OlivierJoris/Shop-customer-counter/README.md

# Shop customer counter
Shop customer counter made using a PIC microcontroller in Assembly. This project has been realized as part of the *Embedded systems project* course given by Bernard Boigelot at the University of Liège during the 2020-2021 academic year.
