OlivierJoris/Shop-customer-counter/0_project_idea/comments.pdf

❖ Sauvegarde de données sur la carte SD pas nécessaire
❖ Laser pas la meilleure solution
- Un laser tout seul n’est pas suffisant. Il faut un module avec un laser mais c’est peut-être trop cher pour le cours
- On peut utiliser une LED avec un “lens”
❖ Remplacer la photo-résistance par un photo-transistor
❖ On peut utiliser un seul système de détection au lieu de 2
- Un seul système de détection avec 2 “détecteurs” (pas de communication bluetooth)
■ En fonction de l’ordre dans lequel les détecteurs sont activés, on peut en déduire si la personne rentre ou sort du magasin
- On peut aussi garder notre système avec les 2 systèmes de détection
