OlivierJoris/Shop-customer-counter/3_modules_interaction/report.pdf

## INFO-2055: Embedded systems project Customer Counter - System modules interaction

Crucifix Arnaud - 170962
Goffart Maxime - 180521
Joris Olivier - 182113

## 1 Modules interaction

We build both types (emitter and receiver) circuits using breadboards.

The issues we have are the following:

1. Phototransistors and IR emitters have a range which is too short.
2. If we are not almost in the dark, the phototransistor does not allow to detect the waves from the IR emitter.

For both issues, we think that it comes from hardware choices. Maybe we do not have the ideal components for what we want to achieve. At the moment, we are using Vishay TSHF5410 (https://be.farnell.com/vishay/tshf5410/emetteur-infrarouge-890nm-t-1/dp/1652534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) as IR emitters and OP598A (https://be.farnell.com/tt-electronics-optek-technology/op598a/phototransistor-plastic-to-18/dp/1497887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) as phototransistors.

1
