OlivierJoris/Shop-customer-counter/4_final_report/diagram.png

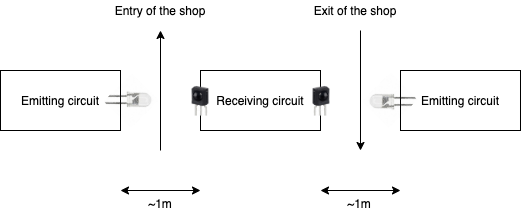
4_final_report/diagram.png
