OlivierJoris/Shop-customer-counter/4_final_report/emitter.png

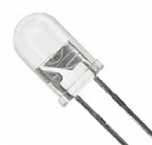
4_final_report/emitter.png
