OlivierJoris/Shop-customer-counter/4_final_report/receiver.png

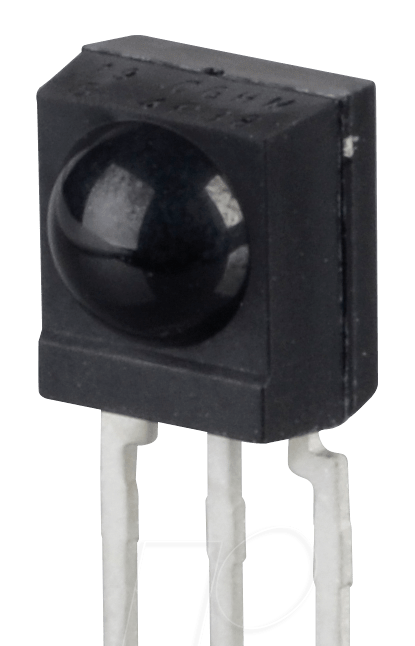
4_final_report/receiver.png
