OlivierJoris/Shop-customer-counter/1_hardware_software/schematic.pdf

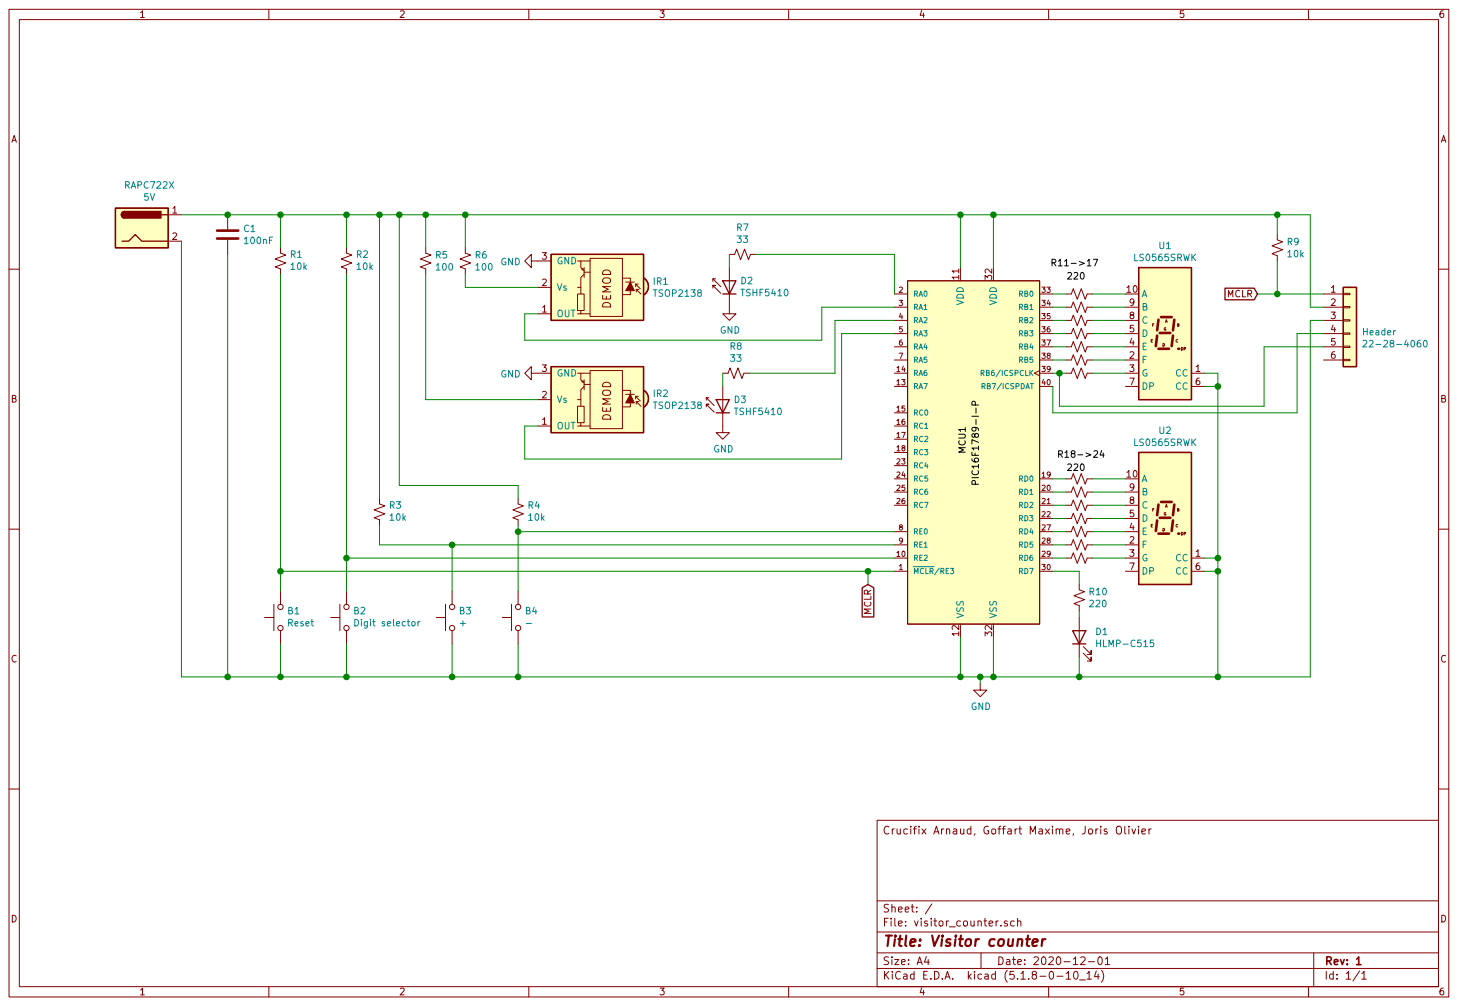
[picture p12: page 1]

File: visitor_counter.sch Sheet: / Crucifix Arnaud, Goffart Maxime, Joris Olivier

Id: 1/1 Title: Visitor counter
