OlivierJoris/Shop-customer-counter/schematics/emitter_circuit/visitor_counter_emitter.pdf

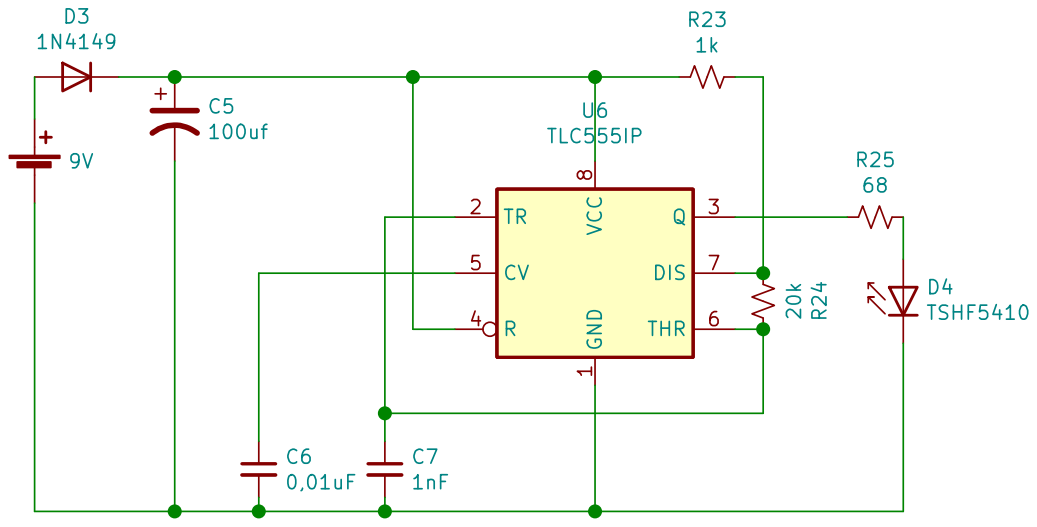
[picture p13: page 1]

INFO-2055: Embedded Systems Project Academic Year: 2020-2021

File: visitor_counter_emitter.sch Sheet: /
Id: 1/1 Title: Visitor Counter Emitter
