OlivierJoris/Shop-customer-counter/schematics/receiver_circuit/visitor_counter_receiver.pdf

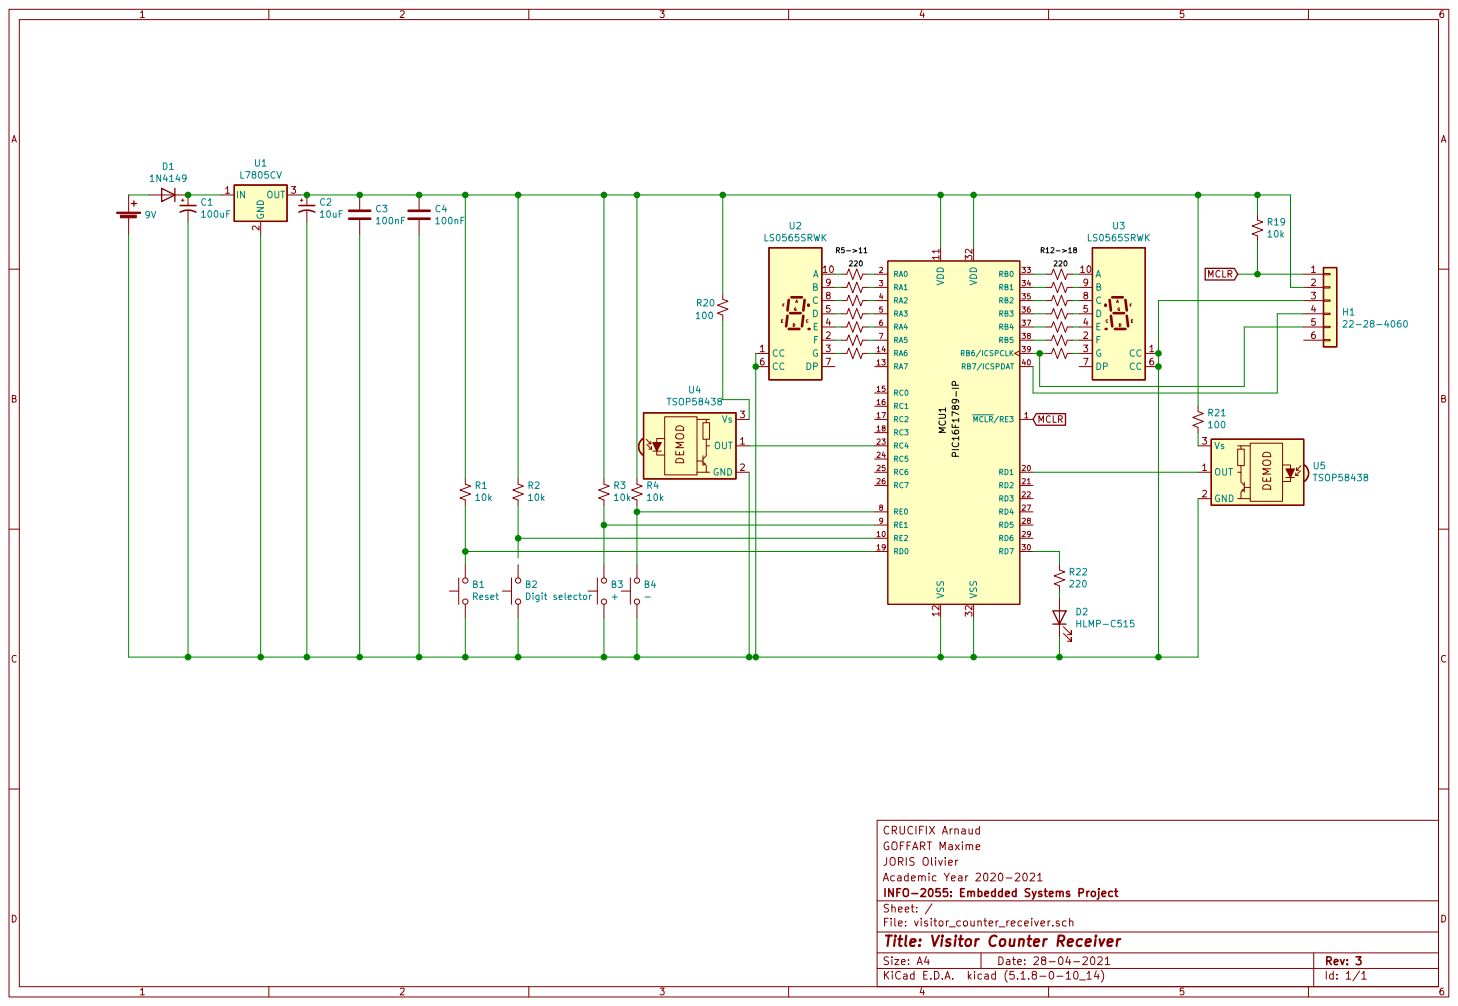
[picture p14: page 1]

JORIS Olivier GOFFART Maxime CRUCIFIX Arnaud

INFO-2055: Embedded Systems Project Academic Year 2020-2021

File: visitor_counter_receiver.sch Sheet: /
Id: 1/1 Title: Visitor Counter Receiver
