OlivierJoris/Shop-customer-counter/1_hardware_software/schematic/visitor_counter.sch

## KiCad design 1_hardware_software/schematic/visitor_counter.sch (2021-02-26)

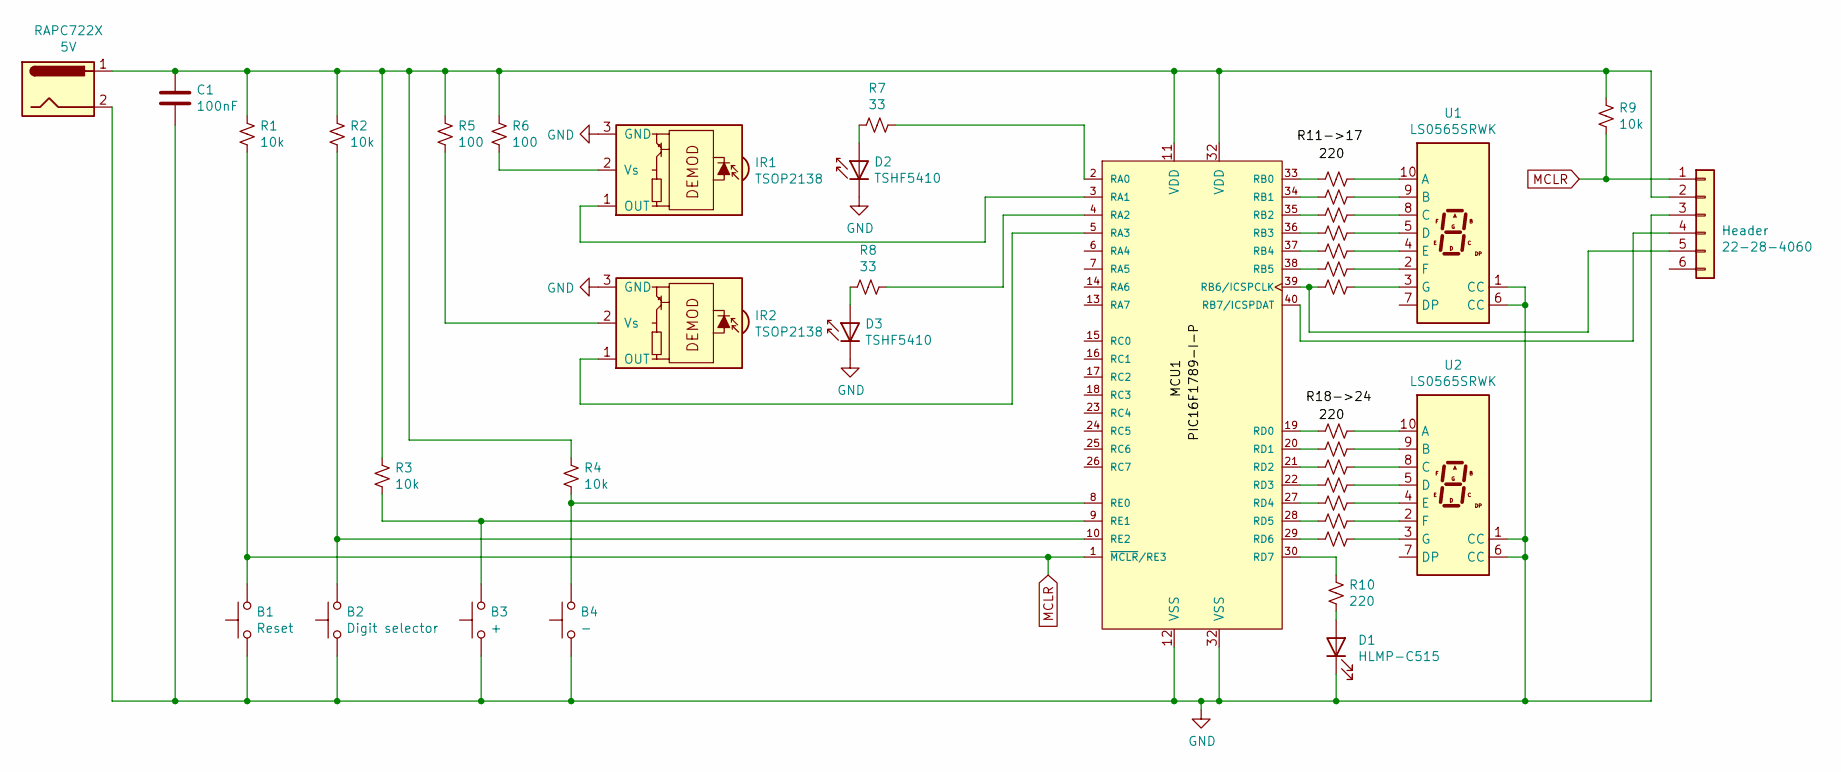
[picture p15: schematic visitor_counter.sch]

Parts:
B1: Reset
B2: Digit selector
B3: +
B4: -
C1: 100nF
D1: HLMP-C515
D2, D3: TSHF5410; LED_D3.0mm_IRBlack
Header: 22-28-4060
IR1, IR2: TSOP2138; Vishay_MOLD-3Pin
R1, R2, R3, R4, R9: 10k
R5, R6: 100
R7, R8: 33
R10: 220
RAPC722X: 5V
U: PIC16F1789-I_P; Microchip-PIC16F1789-I_P-*
U1, U2: LS0565SRWK; HDSP-A151

Connections:
GND: B1.1, B2.1, B3.1, B4.1, C1.2, D1.1 (K), D2.1 (K), D3.1 (K), Header.3, IR1.3 (GND), IR2.3 (GND), RAPC722X.2, U.12 (VSS), U.32 (VDD), U1.1 (CC), U1.6 (CC), U2.1 (CC), U2.6 (CC)
MCLR: B1.2, Header.1, R1.1, R9.2, U.1 (~MCLR~/RE3)
unnamed: B2.2, R2.1, U.10 (RE2)
unnamed: B3.2, R3.1, U.9 (RE1)
unnamed: B4.2, R4.1, U.8 (RE0)
unnamed: C1.1, Header.2, R1.2, R2.2, R3.2, R4.2, R5.1, R6.1, R9.1, RAPC722X.1, U.11 (VDD), U.32 (VDD)
unnamed: D1.2 (A), R10.2
unnamed: D2.2 (A), R7.1
unnamed: D3.2 (A), R8.1
unnamed: Header.4, U.40 (RB7/ICSPDAT)
unnamed: Header.5, U.39 (RB6/ICSPCLK)
unnamed: IR1.1 (OUT), U.3 (RA1)
unnamed: IR1.2 (Vs), R6.2
unnamed: IR2.1 (OUT), U.5 (RA3)
unnamed: IR2.2 (Vs), R5.2
unnamed: R7.2, U.2 (RA0)
unnamed: R8.1, U.19 (RD0)
unnamed: R8.2, U.4 (RA2), U2.10 (A)
unnamed: R10.1, U.30 (RD7)
