OlivierJoris/Shop-customer-counter/schematics/emitter_circuit/visitor_counter_emitter.sch

## KiCad design schematics/emitter_circuit/visitor_counter_emitter.sch (2021-05-02)

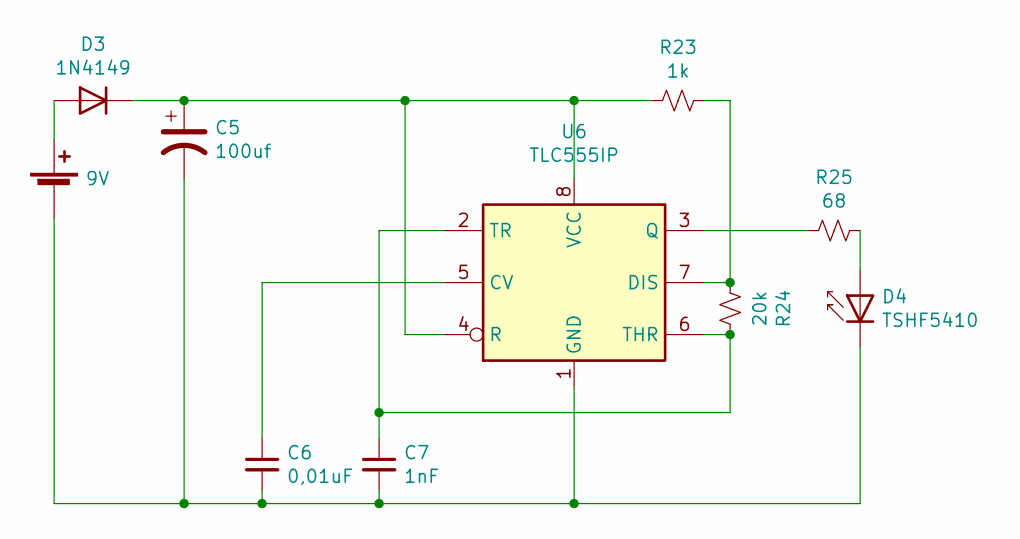
[picture p16: schematic visitor_counter_emitter.sch]

Parts:
C5: 100uf
C6: 0,01uF
C7: 1nF
D3: 1N4149; D_DO-35_SOD27_P7.62mm_Horizontal
D4: TSHF5410; LED_D3.0mm_IRBlack
R23: 1k
R24: 20k
R25: 68
U6: TLC555IP; DIP-8_W7.62mm

Connections:
unnamed: C5.1, D3.1 (K), R23.1, U6.4 (R), U6.8 (VCC)
unnamed: C5.2, C6.2, C7.2, D4.1 (K), U6.1 (GND)
unnamed: C6.1, U6.5 (CV)
unnamed: C7.1, R24.2, U6.2 (TR), U6.6 (THR)
unnamed: D4.2 (A), R25.2
unnamed: R23.2, R24.1, U6.7 (DIS)
unnamed: R25.1, U6.3 (Q)
