OlivierJoris/Shop-customer-counter/schematics/receiver_circuit/visitor_counter_receiver.sch

## KiCad design schematics/receiver_circuit/visitor_counter_receiver.sch (2021-04-28)

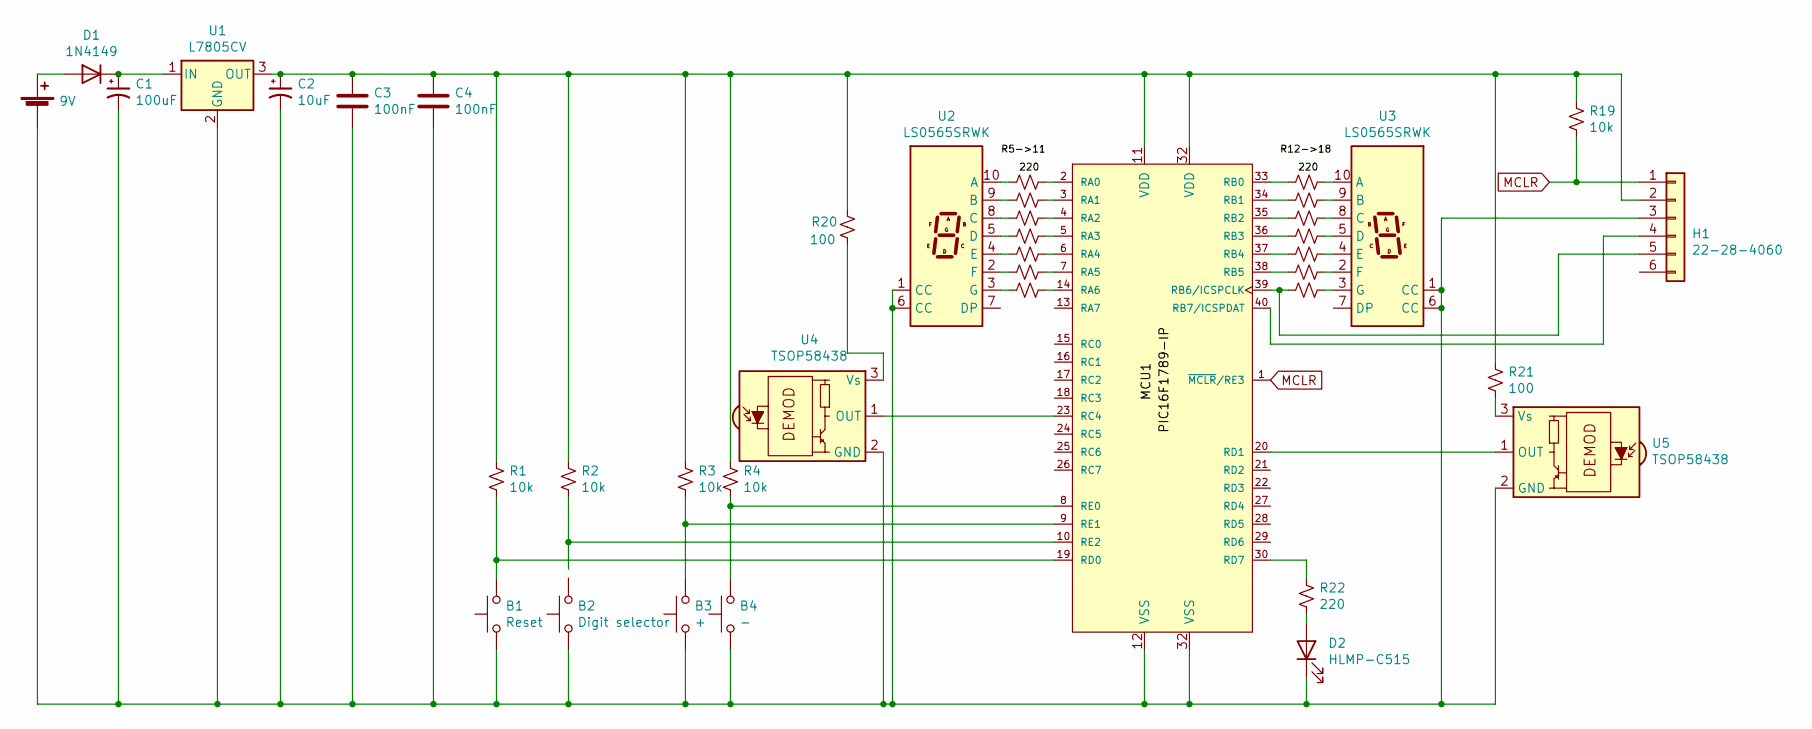
[picture p17: schematic visitor_counter_receiver.sch]

Parts:
B1: Reset
B2: Digit selector
B3: +
B4: -
C1: 100uF
C2: 10uF
C3, C4: 100nF
D1: 1N4149; D_DO-35_SOD27_P7.62mm_Horizontal
D2: HLMP-C515
H1: 22-28-4060
R1, R2, R3, R4, R19: 10k
R20, R21: 100
R22: 220
U: PIC16F1789-I_P; Microchip-PIC16F1789-I_P-*
U1: L7805CV
U2, U3: LS0565SRWK; HDSP-A151
U4, U5: TSOP58438; Vishay_MINICAST-3Pin

Connections:
MCLR: H1.1, R19.2, U.1 (~MCLR~/RE3)
unnamed: B1.1, B2.1, B3.1, B4.1, C1.2, C2.2, C3.2, C4.2, D2.1 (K), H1.3, U.12 (VSS), U.32 (VDD), U1.2 (GND), U2.1 (CC), U2.6 (CC), U3.1 (CC), U3.6 (CC), U4.2 (GND), U5.2 (GND)
unnamed: B1.2, R1.1, U.19 (RD0)
unnamed: B3.2, R3.1, U.9 (RE1)
unnamed: B4.2, R4.1, U.8 (RE0)
unnamed: C1.1, D1.1 (K), U1.1 (IN)
unnamed: C2.1, C3.1, C4.1, H1.2, R1.2, R2.2, R3.2, R4.2, R19.1, R20.2, R21.2, U.11 (VDD), U.32 (VDD), U1.3 (OUT)
unnamed: D2.2 (A), R22.2
unnamed: H1.4, U.40 (RB7/ICSPDAT)
unnamed: H1.5, U.39 (RB6/ICSPCLK)
unnamed: R2.1, U.10 (RE2)
unnamed: R20.1, U4.3 (Vs)
unnamed: R21.1, U5.3 (Vs)
unnamed: R22.1, U.30 (RD7)
unnamed: U.20 (RD1), U5.1 (OUT)
unnamed: U.23 (RC4), U4.1 (OUT)
