OlivierJoris/Shop-customer-counter/(commit log)

2021-02-11 sensors test code
2021-02-14 Actuators!
    To implement someday:
    - splitting counter
    - digit selector button
2021-02-16 update button_tests
2021-02-18 Add comment old actuators.s
2021-02-18 Single button
2021-02-18 All buttons (glitching)
2021-02-26 Backup Google Drive
    [components_farnell.csv, visitor_counter.sch, visitor_counter_emitter.sch, visitor_counter_receiver.sch]
2021-03-13 Handle buttons update
2021-03-15 Correcting issue with reset button
    [visitor_counter_emitter.sch, visitor_counter_receiver.sch]
2021-03-15 Don't call update setup display in interrupt
2021-04-19 Components list
    [excel_list.xlsx, list.csv]
2021-04-28 Correction schematics
    [visitor_counter_emitter.sch, visitor_counter_receiver.sch]
2021-04-28 Update components list
    [emitter_list.csv, emitter_list.xlsx, excel_list.xlsx, list.csv, receiver_list.csv, receiver_list.xlsx]
2021-04-28 Components + png
    [emitter_list.xlsx, receiver_list.xlsx]
2021-04-29 Update assembly code
2021-05-02 Modif schematic emitter
    [emitter_list.csv, emitter_list.xlsx, visitor_counter_emitter.sch]
